HAMakaryan/Cutter/README.md

# Cutter
Project TopRub.
The project intendet to modern the paper cutter machine.
This project based on NUCLEO-F767ZI board.
