HAMakaryan/Cutter/BlockDiagrams/state_machine.pdf

do / Changing of set and real coordinates, cutting Reads pressed key if buttons are released / defer Reads inputs / defer
if pressed 0-9 goes Edit set coord mode / defer
if pressed * goes Auto mode / defer
If pressed D goes Menu / defer
User can cut, change coord with hand catch or / defer back/forward buttons, also can change automatically / defer

Manual State

B

do / Changing of set coord
Collects pressed numbers and / defer
creates number / defer
if pressed # 2 times goes Brush Moving mode / defer if pressed * deletes last digit / defer
if pressed B goes Manual mode / defer

Edit set coord state

B

do / Has only callibration option / defer
If pressed B goes Manual mode / defer if pressed C goes Callibration mode / defer

Menu state
do / Changing of real coordinate
Uses hand catch / defer
if released hand catch goes Manual or / defer Callibration or Auto mode / defer

Hand catch state
do / Cutting paper
Uses pedal and cutting button / defer
if released pedal button goes Manual or / defer Callibration or Auto mode / defer

Cutting
do / Changing of real coord
Uses forward/ back button / defer
if released back/forward button goes Manual or / defer Callibration or Auto mode / defer

Brush Moving with back/forward button

do / Changing of real coord
Uses keypad / defer
if pressed # creates number / defer
if pressed second # goes Manual / defer if pressed B goes Manual / defer

Callibration
do / Changing of real coord
Move brush by motor and encoder / defer
After ending brush moving goes Manual mode / defer

Brush Moving state

do / Working with A-D coordinates
User can change A-D coordinates / defer
Do cutting / defer
Move brush to desired coordinate by hand catch or / defer back/forward buttons / defer
if pressed A-D, real coord saved to according coordinate / defer
if pressed 0-9 goes Edit set coord mode / defer
if pressed * goes Manual mode / defer
if pressed # waits for entering A-D to move brush automatically and to cut / defer

Auto state

A-D or *

do / Changing of set coord
Collects pressed numbers and / defer
creates number after press A-D / defer
After pressing A-D goes Auto mode / defer
if all digits are 0, user can return back by * / defer

Edit set coord in auto mode do / Waiting for A-D pressing
User can press A/B/C/D to go Start mode / defer
if pressed * goes Auto mode / defer
if not pressed A-D, after 1 minute automatically goes / defer Auto mode / defer

Wait for start

do / Moving brush to according coordinate
After brush moving goes Wait for cutting mode / defer

Start

do / Waiting for cutting
If cutting is done, goes to Start mode to go to the next coordinate / defer
if current coord is D, after cutting goes to initial pressed coordinate(after #) / defer if pressed * goes Auto mode / defer

Wait for cutting

0-9

2 #

if released | if released | if released

0-9

After brush move

D

*

C

if released

if released

if released

2 # or B

A-D

After brush move

After cutting

* or automatically after 1 minute

*

Power on
