HAMakaryan/Cutter/BlockDiagrams/Cutter.pdf

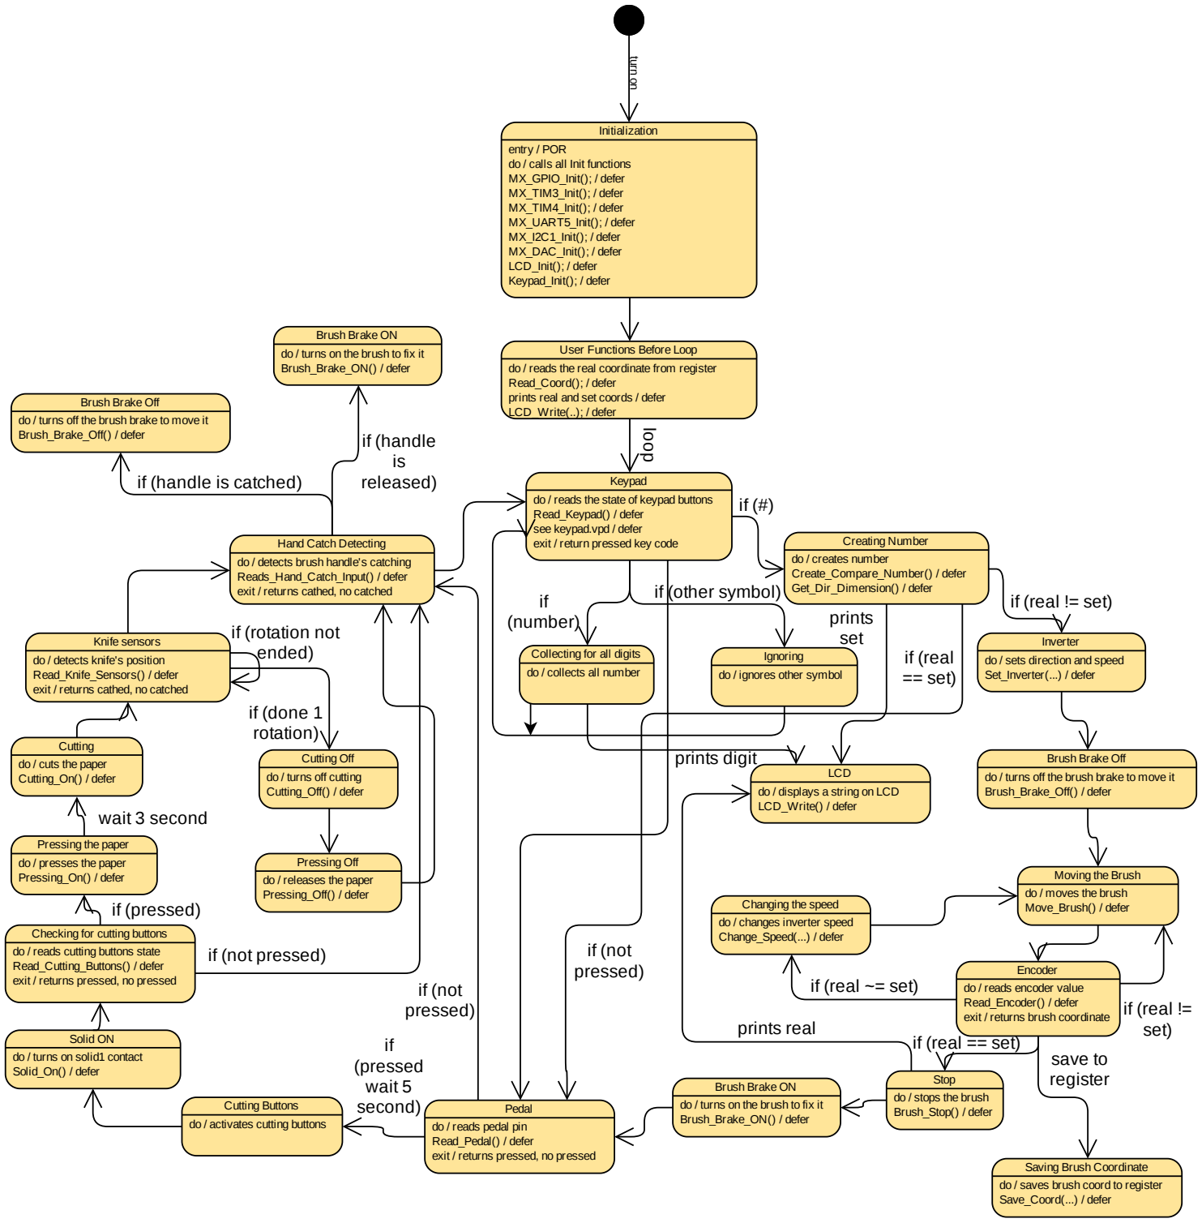
[picture p5: figure]
entry / POR do / calls all Init functions MX_GPIO_Init(); / defer MX_TIM3_Init(); / defer MX_TIM4_Init(); / defer MX_UART5_Init(); / defer MX_I2C1_Init(); / defer MX_DAC_Init(); / defer LCD_Init(); / defer Keypad_Init(); / defer; Initialization; do / reads the state of keypad buttons Read_Keypad() / defer see keypad.vpd / defer exit / return pressed key code; Keypad; do / creates number Create_Compare_Number() / defer Get_Dir_Dimension() / defer; Creating Number; do / sets direction and speed Set_Inverter(...) / defer; Inverter; do / moves the brush Move_Brush() / defer; Moving the Brush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

do / reads the real coordinate from register

do / turns off the brush brake to move it do / turns off the brush brake to move it

## Visual Paradigm Online Diagrams Express Edition

## Visual Paradigm Online Diagrams Express Edition
