HAMakaryan/Cutter/Specification/Մասնահատկություն.docx

# Ներկառուցված ծրագրի մասնահատկությունները

Սնուցումը միացնելուց հետո կատարվում են հետևյալ նախնական կարգաբերման քայլերը․

MX_GPIO_Init();

MX_TIM3_Init();

MX_TIM4_Init();

MX_UART5_Init();

MX_I2C1_Init();

MX_DAC_Init();

LCD_Init();

Այս քայլերից հետո ծրագիրը հատուկ ռեգիստրից (սնուցումից անկախ) կարդում է (Read_Coord()) սանրի փաստացի կոորդինատը(այսինքն թղթի կտրվելիք չափսը) և արտացոլում է (LCD_Write()) ցուցասարքի վրա։ Ցուցասարքը արտացոլում է նաև նախորդ ցանկալի կոորդինատը։ Քանի դեռ օգտագործողը չի փոխել սանրի կոորդինատը, ապա ցանկալի արժեքը կլինի նույնը, ինչ փաստացի արժեքն է։

Օրինակ․

Real 0200.0 mm – փաստացի կոորդինատ

Set 0200.0 mm – ցանկալի կոորդինատ

Եթե օգտագործողին բավարարում է թղթի կտրվելիք չափսը, կարող է անցնել կտրելու փուլ, հակառակ դեպքում ստեղնաշարի օգնությամբ կարող է մուտքագրել նոր կոորդինատը և հրամայել սանրին գնալ նոր կոորդինատ։

Նոր կոորդինատ մուտքագրելու համար․

1. Ծրագիրը սպասում է ստեղնաշարից թվի մուտքագրմանը(Read_Keypad())
2. Եթե մուտքագրվածը թիվ է, ապա ծրագիրը զրոյացնում է ցանկալի կոորդինատի արժեքը և պատկերում է մուտքագրված թիվը ցուցասարքի համապատասխան դիրքում(LCD_Write()) (աջից ձախ տեղաշարժելով մուտքագրված թվերը)։
3. Ամեն հաջորդ մուտքագրված թվից առաջ ծրագիրը պահում է նախորդ թիվը, որպեսզի վերջում այդ թվանշաններից թիվ կազմի․
4. Ծրագիրը կրկնում է 1-3 կետերը, քանի դեռ ստեղնաշարից ստանում է 0-9 թվերը
5. Եթե ծրագիրը ստացել է 0-9-ից կամ #-ից տարբեր նշան, արհամարհում է այն և շարունակում է 1 կետից
6. Եթե ստացել է # նշան, ապա ծրագիրը կազմում է թիվ և ցուցասարքը արտացոլում է “Are you sure? “
7. 2-րդ #-ի միջոցով հաստատում ենք և հրամայում ենք սանրին, որպեսզի տեղաշարժվի, իսկ *-ի միջոցով ջնջում ենք առաջին #-ը և մտնում թվի փոփոխման ռեժիմ

Այսքանով որոշվեց կտրվելիք թղթի չափսը։ Ցուցասարքը կարտացոլի նոր կոորդինատը(ցանկալի կոորդինատը) և փաստացի կոորդինատը։

Օրինակ․

Real 0200.0 mm – փաստացի արժեք

Set 0400.0 mm – ցանկալի արժեք

Սանրին հրամայելու համար․

- Բաղդատում է կազմված թիվը ընթացիկ դիրքի հետ
- Որոշում է շարժման ուղղությունը, մեծությունը, արագությունը:

Մեծությունը փաստացի և ցանկալի կոորդինատների տարբերությունն է:

1. Անջատում է սանրի արգելակը(Brush_Unlock()) և ստուգում է արգելակի վիճակը: Brush_Unlock() ֆունկցիան վերադարձնում է հետևյալ վիճակները․

0 – unlock, երբ հոսանք չկա և անջատել ենք սանրի արգելակը, կամ երբ հոսանք կա և անջատել ենք սանրի արգելակը

1– lock երբ հոսանք կա և միացրել ենք սանրի արգելակը

2. Եթե հոսանք կա և անջատվել է սանրի արգելակը, ապա ծրագիրը DAC-ի միջոցով կարգաբերում է ինվերտորի նախնական արագությունը, իսկ ուղղությունից ելնելով միացնում է միացնում է (Set_Inverter()) hաճախային վերափոխիչի առաջ(Brush_Forward) կամ հետ(Brush_Back) ելքը:

Ծրագիրը պարբերաբար ստուգում է էնկոդերի արժեքը(էնկոդերը միացված է սանրին և գրանցում է սանրի տեղաշարժը) և ցանկալի կոորդինատին մոտենալիս դանդաղեցնում է շարժիչի արագությունը(Change_Speed(ramp-down) (Change_Speed(ramp-up) շարժումը սկսելիս)) և հասնելուն պես՝ անջատում հաճախային վերափոխիչը (Set_Inverter()) ու միացնում է սանրի արգելակը(Brush_Lock()), որպեսզի շարժիչը իներցիայով առաջ չգնա։

Նախապես հայտարարված ramp_up, ramp_down արժեքներով են որոշվում թե որքանով դանդաղի շարժիչի արագությունը։

Ծրագիրը backup register-ում գրանցում է սանրի փաստացի կոորդինատը(Save_Coord()) (ցանկալի երևույթ - եթե համակարգի հոսանքը անջատվել է, այդ դեպքում նույնպես ծրագիրը պահպանում է սանրի փաստացի կոորդինատը):

Ծրագրում դրված են 2 soft limit-ներ, որոնցից մեկը վերևից է սահմանափակում սանրի տեղաշարժը, մյուսը՝ ներքևից։ Եվ եթե սանրը հանդիպում է այդ soft limit-ներից որևէ մեկին, ապա ծրագիրը անջատում է շարժիչը և միայն հակառակ ուղղությամբ թույլատրում սանրի շարժումը։

Ցուցասարքը կարտացոլի նոր(փաստացի) կոորդինատը, և օգտագործողը կարող է անցնել կտրման փուլ։

Օրինակ․

Real 0400.0 mm – փաստացի արժեք

Set 0400.0 mm – ցանկալի արժեք

Կտրելու Փուլ։

1. Կտրելու փուլ անցնելու համար օգտագործողը պետք է սեղմած պահի ոտնակը(պեդալը)։ Ծրագիրը ստուգում է, եթե սեղմված է պեդալը(Read_Pedal()), սկիզբ է դնում է 5 վայրկյանանոց հապաղմանը, որի ավարտից հետո ծրագիրը միացնելով (Cutting_Buttons թույլատ․) ռելեն ակտիվացնում է կտրելու կոճակները (Cutting_Buttons):
2. Հապաղումից հետո, եթե ոտնակը դեռ սեղմված է միաժամանակ սեղմած պահել կտրելու համար նախատեսված երկու կոճակները(Cutting_Buttons)։ Ծրագիրը ակտիվացնում է (Pressing_On()) հիդրավլիկի փականը(Press_Again), որը սկիզբ է դնում 3 վայրկյանանոց հապաղմանը։ Մամլիչը էլ ավելի ուժգին է սեղմում թուղթը։ Հապաղումից հետո ծրագիրը միացնում է Cutting allow ռելեն, որի արդյունքում միանում է դանակի կցորդիչը։

Դանակը իջնում, կտրում է թուղթը և վերադառնում է ելման դիրք։ Դանակի թափանիվի վրա տեղակայված երկու տվիչների արժեքները կարդալով(Read_Knife_Sensors()) ծրագիրը որոշում է երբ թույլատրի դանակի շարժումը և երբ անջատի դանակի կցորդիչը Cutting allow ռելեի միջոցով։ Դանակի կցորդիչը անջատելուց (Cutting_Off()) հետո, ծրագիրը անջատում է հիդրավլիկայի փականը(Pressing_Off()) (Cutting_Buttons allow ) ռելեի միջոցով : Որից հետո օգտագործողը բաց է թողնում ոտնակը և մամլիչը ազատում է կտրված թուղթը։

1. Ակտիվանում է սանրի տեղաշարժելու մեխանիզմը և կտրված թուղթը հրում է առաջ, որպեսզի օպերատորը հեշտ աշխատի։

Թուղթը նորից կտրելու համար պետք է սկսել 1-ին կետից։

Ոտնակը բաց թողնելուց հետո օգտագործողը ցանկության դեպքում կարող է փոխել սանրի կոորդինատը։

Օգտագործողը կարող է նաև ձեռքով տեղաշարժել սանրը՝ բռնակը սեղմած պահելով։ Ծրագիրը ստուգում է (Read_Hand_Catch_Input()) համապատասխան մուտքը(Hand_Catch) և եթե նկատվել է բռնակի սեղմում, ապա ծրագիրը անջատում է սանրի արգելակը(Brush_Unlock())։ Այնուհետև օգտագործողը կարող է տեղաշարժել սանրը։ Ցանկալի դիրք տանելուց հետո օգտագործողը թողնում է բռնակը և ծրագիրը միացնում է արգելակը(Brush_Lock())։ Ընթացիկ կոորդինատը արտացոլվում է ցուցասարքին(LCD_Write()) և ծրագիրը պահում է սանրի կոորդինատը պահեստային ռեգիստրի մեջ(Save_Coord())։ Եթե համակարգը անջատված է, ապա օգտագործողը չի կարող տեղաշարժել սանրը, քանի որ այն բլոկավորված է բլոկավորող համակարգի կողմից։

Եթե սանրի գտնվելու կոորդինատը և ցուցասարքին տպված փաստացի կոորդինատը չեն համընկնում, օգտագործողը կարող է փոխել այդ թիվը։

Լրացնել․․
