HAMakaryan/Cutter/ProjectsHW/Fragments/AC2MCU/ac2mcu_if.asc

C1: cap; .50µF
R1: res; 100K
R2: res; 300K
U1: MOC205
V1: voltage; SINE(0 300 50 0 0 0 100)
V2: voltage; 5
Named nets: 0
.tran 3s
