HAMakaryan/Cutter/(list of files, drawings)

Other design files:
ProjectsHW/Cutter/Cutter.PrjPcb
ProjectsHW/Cutter/Cutter_Top.SchDoc
