HAMakaryan/Cutter/ProjectsSW/Core/Src/main.c

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
/* Includes ------------------------------------------------------------------*/
#include "main.h"
#include "cmsis_os.h"
#include "dac.h"
#include "i2c.h"
#include "rtc.h"
#include "tim.h"
#include "gpio.h"

/* USER CODE BEGIN Includes */
#include "stdio.h"
#include "cutter.h"
#include <string.h>
extern uint8_t number_accept_count;
/* USER CODE END Includes */


void SystemClock_Config(void);
void MX_FREERTOS_Init(void);
/* USER CODE BEGIN PFP */
static void Read_Real_Coord();
static void Print_Initial_Status();
/* USER CODE END PFP */

/* USER CODE BEGIN 0 */
double real_coord = 0;
extern int32_t encoder_value;
extern double set_coord;
extern uint8_t keypad_timeout;
/* USER CODE END 0 */

/**
  * @brief  The application entry point.
  * @retval int
  */
int main(void)
{
  /* MCU Configuration--------------------------------------------------------*/

  /* Reset of all peripherals, Initializes the Flash interface and the Systick. */
  HAL_Init();

  /* USER CODE BEGIN Init */
  /*enable the power and backup interface clocks by setting the PWREN and
   * BKPEN bits in the RCC_APB1ENR register */
	__HAL_RCC_PWR_CLK_ENABLE();
	//__HAL_RCC_BKP_CLK_ENABLE();
  /* USER CODE END Init */

  /* Configure the system clock */
  SystemClock_Config();

  /* Initialize all configured peripherals */
  MX_GPIO_Init();
  MX_TIM3_Init();
  MX_TIM4_Init();
  MX_I2C1_Init();
  MX_DAC_Init();
  MX_RTC_Init();
  /* USER CODE BEGIN 2 */
  //Reads real coord from backup register
  Read_Real_Coord();
  Read_Coords();
  //Prints real and set coords to LCD
  Print_Initial_Status();
  //Inits 4x4 Keypad
  Keypad_Init();
  //Enables interrupt for LCD
  //HAL_NVIC_SetPriority(I2C1_EV_IRQn, 0, 0);
  //HAL_NVIC_EnableIRQ(I2C1_EV_IRQn);
  //Starts encoder
  HAL_TIM_Encoder_Start_IT(&htim4, TIM_CHANNEL_1);
  /* USER CODE END 2 */

  /* Init scheduler */
  osKernelInitialize();  /* Call init function for freertos objects (in freertos.c) */
  MX_FREERTOS_Init();
  /* Start scheduler */
  osKernelStart();

  /* We should never get here as control is now taken by the scheduler */
  /* Infinite loop */
  /* USER CODE BEGIN WHILE */

  while (1)
  {

    /* USER CODE END WHILE */

    /* USER CODE BEGIN 3 */
  }
  /* USER CODE END 3 */
}

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
/* USER CODE BEGIN 4 */
static void Read_Real_Coord()
{
	//Save_Coord(0);
	encoder_value = Read_Coord();
	real_coord = (double)encoder_value * ONE_ROTATION_VAL / ONE_ROTATION_TICK;
	set_coord = real_coord;
}

static void Print_Initial_Status()
{
	LCD_Init(LCD_ADDR);
	/*char buf[10];
	sprintf(buf, "%6.1f", real_coord);
	LCD_SendCommand(LCD_ADDR, ROW_1);
	LCD_SendString(LCD_ADDR, "R                   ");
	LCD_SendCommand(LCD_ADDR, R_COORD_POS);
	LCD_SendString(LCD_ADDR, buf);
	LCD_SendCommand(LCD_ADDR, ROW_3);
	LCD_SendString(LCD_ADDR, "*-Auto              ");
	LCD_SendCommand(LCD_ADDR, ROW_4);
	LCD_SendString(LCD_ADDR, "S             A-Menu");*/
}
/* USER CODE END 4 */

 /**
  * @brief  Period elapsed callback in non blocking mode
  * @note   This function is called  when TIM2 interrupt took place, inside
  * HAL_TIM_IRQHandler(). It makes a direct call to HAL_IncTick() to increment
  * a global variable "uwTick" used as application time base.
  * @param  htim : TIM handle
  * @retval None
  */
void HAL_TIM_PeriodElapsedCallback(TIM_HandleTypeDef *htim)
{
  if (htim->Instance == TIM2) {
    HAL_IncTick();
  }
}

/**
  * @brief  This function is executed in case of error occurrence.
  * @retval None
  */
void Error_Handler(void)
{
  /* USER CODE BEGIN Error_Handler_Debug */
  /* User can add his own implementation to report the HAL error return state */

  /* USER CODE END Error_Handler_Debug */
}

#ifdef  USE_FULL_ASSERT
/**
  * @brief  Reports the name of the source file and the source line number
  *         where the assert_param error has occurred.
  * @param  file: pointer to the source file name
  * @param  line: assert_param error line source number
  * @retval None
  */
void assert_failed(uint8_t *file, uint32_t line)
{
  /* USER CODE BEGIN 6 */
  /* User can add his own implementation to report the file name and line number,
     tex: printf("Wrong parameters value: file %s on line %d\r\n", file, line) */
  /* USER CODE END 6 */
}
#endif /* USE_FULL_ASSERT */

/************************ (C) COPYRIGHT STMicroelectronics *****END OF FILE****/
