HAMakaryan/Cutter/ProjectsSW/Cutter.ioc

PD12.GPIO_Label=Encoder_A
PG8.Signal=GPIO_Input
PC12.Signal=UART5_TX
PB14.GPIO_Label=LD3 [Red]
PG6.GPIO_Label=USB_PowerSwitchOn [STMPS2151STR_EN]
PA14.GPIO_Label=TCK
PC6.GPIO_Label=PWM
PB13.Signal=ETH_TXD1
PD6.GPIO_Label=Move_Brush_Forward
PG13.Signal=ETH_TXD0
PB6.Signal=I2C1_SCL
PH1/OSC_OUT.Signal=RCC_OSC_OUT
PD0.Signal=CAN1_RX
PD8.Signal=USART3_TX
PF10.GPIO_Label=Lock [Lock/Unlock the handle]
PB2.Signal=GPIO_Output
PF12.GPIO_Label=Row1 [Keypad row 1]
PC4.GPIO_Label=RMII_RXD0 [LAN8742A-CZ-TR_RXD0]
PE9.Signal=GPIO_Input
PB1.GPIO_Label=DB4
PA8.Signal=USB_OTG_FS_SOF
PB9.Signal=I2C1_SDA
PB1.Signal=GPIO_Output
PD12.Signal=S_TIM4_CH1
PA10.Signal=USB_OTG_FS_ID
PE12.GPIO_Label=Brush_Back [Moves the brush back]
PF14.Signal=GPIO_Input
PD15.Signal=GPIO_Input
PD9.GPIO_Label=STLK_TX [STM32F103CBT6_PA2]
PC13.Signal=GPXTI13
PA9.GPIO_Label=USB_VBUS
PC6.Signal=S_TIM3_CH1
PB11.GPIO_Label=Relay_4 [For future use]
PD7.Signal=SPI1_MOSI
PD1.Signal=CAN1_TX
PA11.GPIO_Label=USB_DM
PF14.GPIO_Label=Pedal_In [Pedal pressing detection pin]
PF13.GPIO_Label=Row0 [Keypad row 0]
PG13.GPIO_Label=RMII_TXD0 [LAN8742A-CZ-TR_TXD0]
PD10.Signal=GPIO_Input
PA8.GPIO_Label=USB_SOF [TP1]
PE8.GPIO_Label=Cutting_Buttons_Allow
PA9.Signal=USB_OTG_FS_VBUS
PE9.GPIO_Label=Hand_Catch [Hand catch detection pin]
PB10.Signal=GPIO_Output
PB14.Signal=GPIO_Output
PA5.Signal=SPI1_SCK
PE14.Signal=GPIO_Output
PE15.Signal=GPIO_Output
PB4.GPIO_Label=DB1
PB15.GPIO_Label=DB5
PE8.Signal=GPIO_Output
PG7.GPIO_Label=USB_OverCurrent [STMPS2151STR_FAULT]
PF4.GPIO_Label=DB7
PA1.GPIO_Label=RMII_REF_CLK [LAN8742A-CZ-TR_REFCLK0]
PF13.Signal=GPIO_Input
PG14.GPIO_Label=Row2 [Keypad row 2]
PA4.Signal=COMP_DAC1_group
PB5.Signal=GPIO_Output
PE13.GPIO_Label=Cutting [On/Off cutting]
PD11.Signal=GPIO_Output
PA11.Signal=USB_OTG_FS_DM
PF9.Signal=GPIO_Input
PC15/OSC32_OUT.Signal=RCC_OSC32_OUT
PF4.Signal=GPIO_Output
PC1.Signal=ETH_MDC
PG6.Signal=GPIO_Output
Mcu.UserName=STM32F767ZITx
PA0/WKUP.Signal=ADCx_IN0
PC13.GPIO_Label=USER_Btn [B1]
PB13.GPIO_Label=RMII_TXD1 [LAN8742A-CZ-TR_TXD1]
PB11.Signal=GPIO_Output
PB15.Signal=GPIO_Output
PG11.Signal=ETH_TX_EN
PD13.Signal=S_TIM4_CH2
PA12.Signal=USB_OTG_FS_DP
PD11.GPIO_Label=Air_Out
PF11.GPIO_Label=Col1 [Keypad column 1]
PF12.Signal=GPIO_Input
PE13.Signal=GPIO_Output
PF11.Signal=GPIO_Input
PA10.GPIO_Label=USB_ID
PB7.Signal=GPIO_Output
PB7.GPIO_Label=LD2 [Blue]
PD13.GPIO_Label=Encoder_B
PA6.Signal=SPI1_MISO
PC14/OSC32_IN.Signal=RCC_OSC32_IN
PD5.GPIO_Label=Move_Brush_Back
PA2.GPIO_Label=RMII_MDIO [LAN8742A-CZ-TR_MDIO]
PF5.GPIO_Label=DB6
PA15.Signal=SPI1_NSS
PE0.GPIO_Label=Col2 [Keypad column2]
PF5.Signal=GPIO_Output
PB5.GPIO_Label=DB2
PG11.GPIO_Label=RMII_TX_EN [LAN8742A-CZ-TR_TXEN]
PC5.Signal=ETH_RXD1
PE7.Signal=GPIO_Input
PD6.Signal=GPIO_Input
PB4.Signal=GPIO_Output
PA3.Signal=ADCx_IN3
PB3.GPIO_Label=SWO
PD15.GPIO_Label=Knife_Sensor1 [To detect knife's position]
PG7.Signal=GPIO_Input
PC8.Signal=UART5_DE
PC4.Signal=ETH_RXD0
PE14.GPIO_Label=Brush_Forward [Moves the brush forward]
PD9.Signal=USART3_RX
PD5.Signal=GPIO_Input
PA12.GPIO_Label=USB_DP
PD8.GPIO_Label=STLK_RX [STM32F103CBT6_PA3]
PG8.GPIO_Label=Col3 [Keypad column 3]
PA13.Signal=SYS_JTMS-SWDIO
PE15.GPIO_Label=Brush_Lock [Lock/Unlock Brush]
PB10.GPIO_Label=DB0 [Test pin 0]
PF9.GPIO_Label=Power_In
PD10.GPIO_Label=Row3 [Keypad row 3]
PA1.Signal=ETH_REF_CLK
PG14.Signal=GPIO_Input
PH0/OSC_IN.Signal=RCC_OSC_IN
PF10.Signal=GPIO_Output
PC1.GPIO_Label=RMII_MDC [LAN8742A-CZ-TR_MDC]
PF15.GPIO_Label=Col0 [Keypad column 0]
PF15.Signal=GPIO_Input
PD14.GPIO_Label=Knife_Sensor2 [To detect knife's position]
PE0.Signal=GPIO_Input
PE7.GPIO_Label=Cutting_Buttons [To cut the paper]
PE12.Signal=GPIO_Output
PA2.Signal=ETH_MDIO
PA13.GPIO_Label=TMS
PD14.Signal=GPIO_Input
PB3.Signal=SYS_JTDO-SWO
PA7.GPIO_Label=RMII_CRS_DV [LAN8742A-CZ-TR_CRS_DV]
PC5.GPIO_Label=RMII_RXD1 [LAN8742A-CZ-TR_RXD1]
PA14.Signal=SYS_JTCK-SWCLK
PB2.GPIO_Label=DB3
PH0/OSC_IN.GPIO_Label=MCO [STM32F103CBT6_PA8]
PB12.Signal=UART5_RX
PA7.Signal=ETH_CRS_DV
