HAMakaryan/Cutter/ProjectsSW/Core/Inc/main.h

#define USER_Btn_Pin GPIO_PIN_13
#define USER_Btn_GPIO_Port GPIOC
#define DB7_Pin GPIO_PIN_4
#define DB7_GPIO_Port GPIOF
#define DB6_Pin GPIO_PIN_5
#define DB6_GPIO_Port GPIOF
#define Power_In_Pin GPIO_PIN_9
#define Power_In_GPIO_Port GPIOF
#define Lock_Pin GPIO_PIN_10
#define Lock_GPIO_Port GPIOF
#define MCO_Pin GPIO_PIN_0
#define MCO_GPIO_Port GPIOH
#define RMII_MDC_Pin GPIO_PIN_1
#define RMII_MDC_GPIO_Port GPIOC
#define RMII_REF_CLK_Pin GPIO_PIN_1
#define RMII_REF_CLK_GPIO_Port GPIOA
#define RMII_MDIO_Pin GPIO_PIN_2
#define RMII_MDIO_GPIO_Port GPIOA
#define RMII_CRS_DV_Pin GPIO_PIN_7
#define RMII_CRS_DV_GPIO_Port GPIOA
#define RMII_RXD0_Pin GPIO_PIN_4
#define RMII_RXD0_GPIO_Port GPIOC
#define RMII_RXD1_Pin GPIO_PIN_5
#define RMII_RXD1_GPIO_Port GPIOC
#define DB4_Pin GPIO_PIN_1
#define DB4_GPIO_Port GPIOB
#define DB3_Pin GPIO_PIN_2
#define DB3_GPIO_Port GPIOB
#define Col1_Pin GPIO_PIN_11
#define Col1_GPIO_Port GPIOF
#define Row1_Pin GPIO_PIN_12
#define Row1_GPIO_Port GPIOF
#define Row0_Pin GPIO_PIN_13
#define Row0_GPIO_Port GPIOF
#define Pedal_In_Pin GPIO_PIN_14
#define Pedal_In_GPIO_Port GPIOF
#define Col0_Pin GPIO_PIN_15
#define Col0_GPIO_Port GPIOF
#define Cutting_Buttons_Pin GPIO_PIN_7
#define Cutting_Buttons_GPIO_Port GPIOE
#define Cutting_Buttons_Allow_Pin GPIO_PIN_8
#define Cutting_Buttons_Allow_GPIO_Port GPIOE
#define Hand_Catch_Pin GPIO_PIN_9
#define Hand_Catch_GPIO_Port GPIOE
#define Brush_Back_Pin GPIO_PIN_12
#define Brush_Back_GPIO_Port GPIOE
#define Cutting_Pin GPIO_PIN_13
#define Cutting_GPIO_Port GPIOE
#define Brush_Forward_Pin GPIO_PIN_14
#define Brush_Forward_GPIO_Port GPIOE
#define Brush_Lock_Pin GPIO_PIN_15
#define Brush_Lock_GPIO_Port GPIOE
#define DB0_Pin GPIO_PIN_10
#define DB0_GPIO_Port GPIOB
#define Relay_4_Pin GPIO_PIN_11
#define Relay_4_GPIO_Port GPIOB
#define RMII_TXD1_Pin GPIO_PIN_13
#define RMII_TXD1_GPIO_Port GPIOB
#define LD3_Pin GPIO_PIN_14
#define LD3_GPIO_Port GPIOB
#define DB5_Pin GPIO_PIN_15
#define DB5_GPIO_Port GPIOB
#define STLK_RX_Pin GPIO_PIN_8
#define STLK_RX_GPIO_Port GPIOD
#define STLK_TX_Pin GPIO_PIN_9
#define STLK_TX_GPIO_Port GPIOD
#define Row3_Pin GPIO_PIN_10
#define Row3_GPIO_Port GPIOD
#define Air_Out_Pin GPIO_PIN_11
#define Air_Out_GPIO_Port GPIOD
#define Encoder_A_Pin GPIO_PIN_12
#define Encoder_A_GPIO_Port GPIOD
#define Encoder_B_Pin GPIO_PIN_13
#define Encoder_B_GPIO_Port GPIOD
#define Knife_Sensor2_Pin GPIO_PIN_14
#define Knife_Sensor2_GPIO_Port GPIOD
#define Knife_Sensor1_Pin GPIO_PIN_15
#define Knife_Sensor1_GPIO_Port GPIOD
#define USB_PowerSwitchOn_Pin GPIO_PIN_6
#define USB_PowerSwitchOn_GPIO_Port GPIOG
#define USB_OverCurrent_Pin GPIO_PIN_7
#define USB_OverCurrent_GPIO_Port GPIOG
#define Col3_Pin GPIO_PIN_8
#define Col3_GPIO_Port GPIOG
#define PWM_Pin GPIO_PIN_6
#define PWM_GPIO_Port GPIOC
#define USB_SOF_Pin GPIO_PIN_8
#define USB_SOF_GPIO_Port GPIOA
#define USB_VBUS_Pin GPIO_PIN_9
#define USB_VBUS_GPIO_Port GPIOA
#define USB_ID_Pin GPIO_PIN_10
#define USB_ID_GPIO_Port GPIOA
#define USB_DM_Pin GPIO_PIN_11
#define USB_DM_GPIO_Port GPIOA
#define USB_DP_Pin GPIO_PIN_12
#define USB_DP_GPIO_Port GPIOA
#define TMS_Pin GPIO_PIN_13
#define TMS_GPIO_Port GPIOA
#define TCK_Pin GPIO_PIN_14
#define TCK_GPIO_Port GPIOA
#define Move_Brush_Back_Pin GPIO_PIN_5
#define Move_Brush_Back_GPIO_Port GPIOD
#define Move_Brush_Forward_Pin GPIO_PIN_6
#define Move_Brush_Forward_GPIO_Port GPIOD
#define RMII_TX_EN_Pin GPIO_PIN_11
#define RMII_TX_EN_GPIO_Port GPIOG
#define RMII_TXD0_Pin GPIO_PIN_13
#define RMII_TXD0_GPIO_Port GPIOG
#define Row2_Pin GPIO_PIN_14
#define Row2_GPIO_Port GPIOG
#define SWO_Pin GPIO_PIN_3
#define SWO_GPIO_Port GPIOB
#define DB1_Pin GPIO_PIN_4
#define DB1_GPIO_Port GPIOB
#define DB2_Pin GPIO_PIN_5
#define DB2_GPIO_Port GPIOB
#define LD2_Pin GPIO_PIN_7
#define LD2_GPIO_Port GPIOB
#define Col2_Pin GPIO_PIN_0
#define Col2_GPIO_Port GPIOE
