HAMakaryan/Cutter/(commit log)

2020-05-17 Armen's initial version of STM32CubeMX project file
2020-05-17 Changed output project target to STM32CubeIDE
2020-05-17 Added user manual UM1718 "STM32CubeMX for STM32 configuration and initialization C code generation".
2020-05-17 Initial Project for STM32CubeIDE generated by STM32CubeMX. Changed project name to Cutter.ioc
2020-05-17 Added dummy project. The Schematics and libraries to be added
    [Cutter.PrjPcb]
2020-05-17 Added blank schematic sheet Cutter_Top.SchDoc
    [Cutter.PrjPcb, Cutter_Top.SchDoc]
2020-05-18 Added stm32cube ide project for cutter.
2020-05-19 Modified Specification and some gpio pin names.
2020-05-22 Reference schematics for AC to MCU interfacing
2020-05-22 Commit the file that you've staged in your local repository.#
2020-06-15 Read encoder value by interrupt. Done some changes.
2020-07-24 Corrected some bugs in move brush mode.
    [Cutter.ioc, cutter.c, main.c, main.h]
2020-08-01 Added power checking for move brush.
2020-08-03 Corrected bug for MIN, MAX values and added lcd write in case of brush moving.
    [cutter.c, cutter.h]
2020-09-27 Added checking of current coordinate in tick and tick is saved to Backup register.
2020-10-17 Corrected LCD bug. Changed HSE to HSI as clock source.
    [Cutter.ioc, main.c]
2022-05-04 Ուղղվել է forward, back տերմինների հասկացությունը և կիրառությունը։ Callibration mode-ում ավելացվել է սանրի տեղաշարժի թույլտվությունը։ Ավելացվել է կուրսորի թարթում սկզբնական պատուհանին։
2022-05-24 Տպարանի փորձերի հիման վրա կատարված են փոփոխություններ
2022-06-11 Ավելացվել է մինիում և մաքսիմում կոորդինատի արտատպում․ Կատարվելեն որոշ փոփոխություններ կալիբրովկայի պատուհանում․
2022-06-19 Ավելացվել են DELTA_BACK, DELTA_FORWARD, DISTANCE_FOR_MID_SPEED պարամետրերը իներցիայի շեղումներից խուսափելու համար․ Հանվել է SAVE—ը brush moving—ի համար, մնացել է միայն GO_TO—ն։
2022-06-29 Ավելացվել է STOP—ի հնարավորություն Brush Moving-ի ժամանակ *-ի օգնությամբ։ Կատարվել են որոշ փոփոխություններ set coord—ի Min, Max-ի դաշտում։
